BlakeCLewis/PILN/(list of files, drawings)

Other design files:
docs/kiln_controller.fzz
