BlakeCLewis/PILN/(commit log)

2019-06-18 new repository
    [kiln_controller.fzz]
2019-07-27 add fan on gpio 13
2019-07-31 k terms and fan wiring
2019-07-31 max31856 wiring
